dev-zzo/stebus/README.md

# IEEE 1000 / STEBus designs

This repository contains hardware designs based on the IEEE 1000 aka STE bus.

# Designs included

* S68k8: MC68008FN CPU board + bus arbiter
* STEP1: I/O prototyping board
