dev-zzo/stebus/S68k8_revB/S68k8.kicad_pcb

## KiCad design S68k8_revB/S68k8.kicad_pcb (2021-01-23)

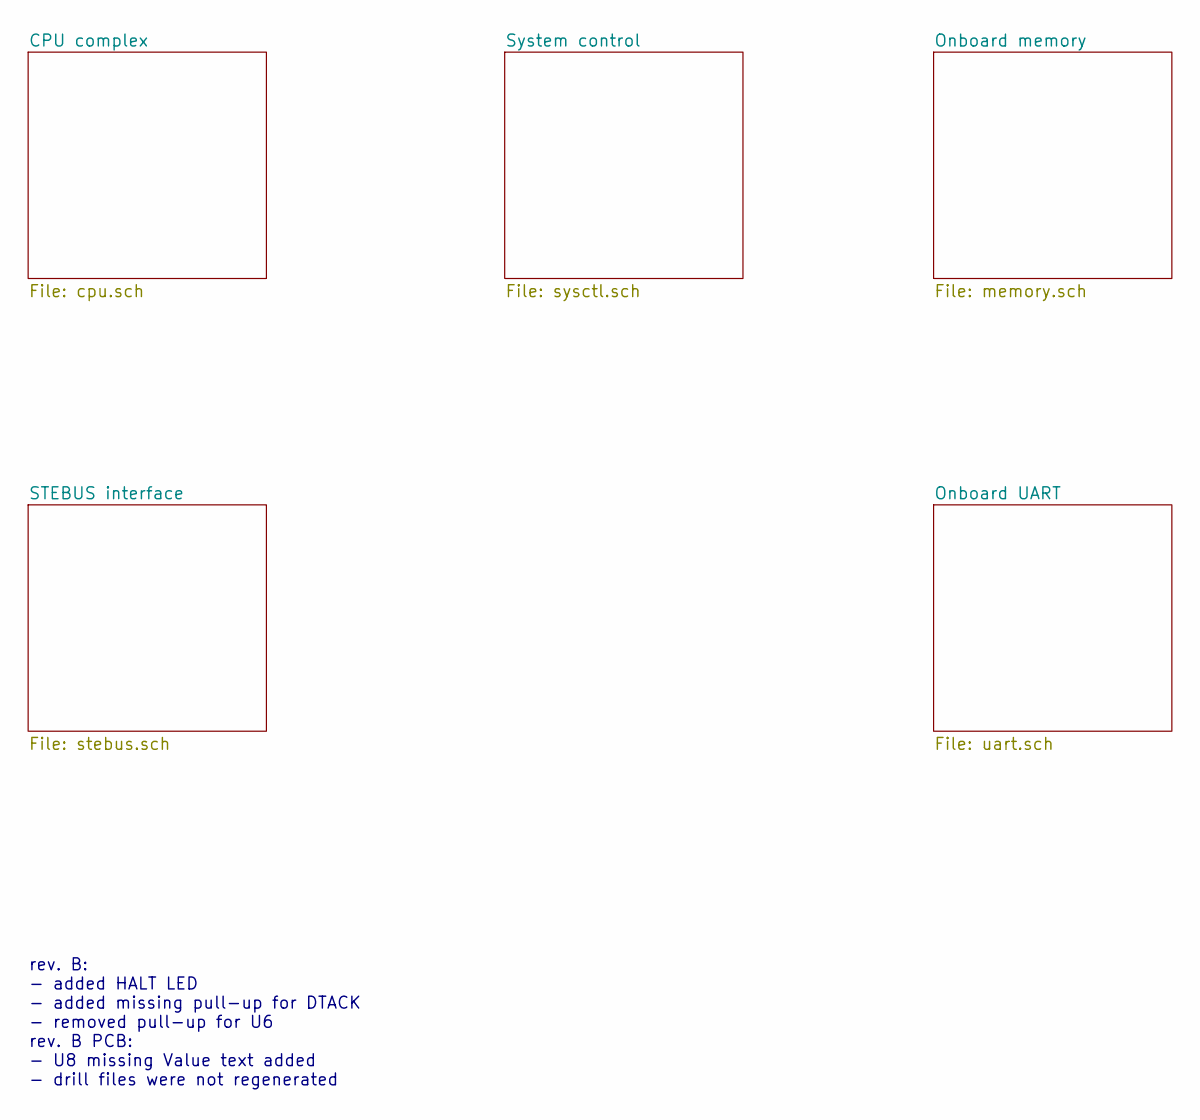
[picture p1: schematic S68k8.sch]

Notes on the sheet:
rev. B: - added HALT LED - added missing pull-up for DTACK - removed pull-up for U6 rev. B PCB: - U8 missing Value text added - drill files were not regenerated

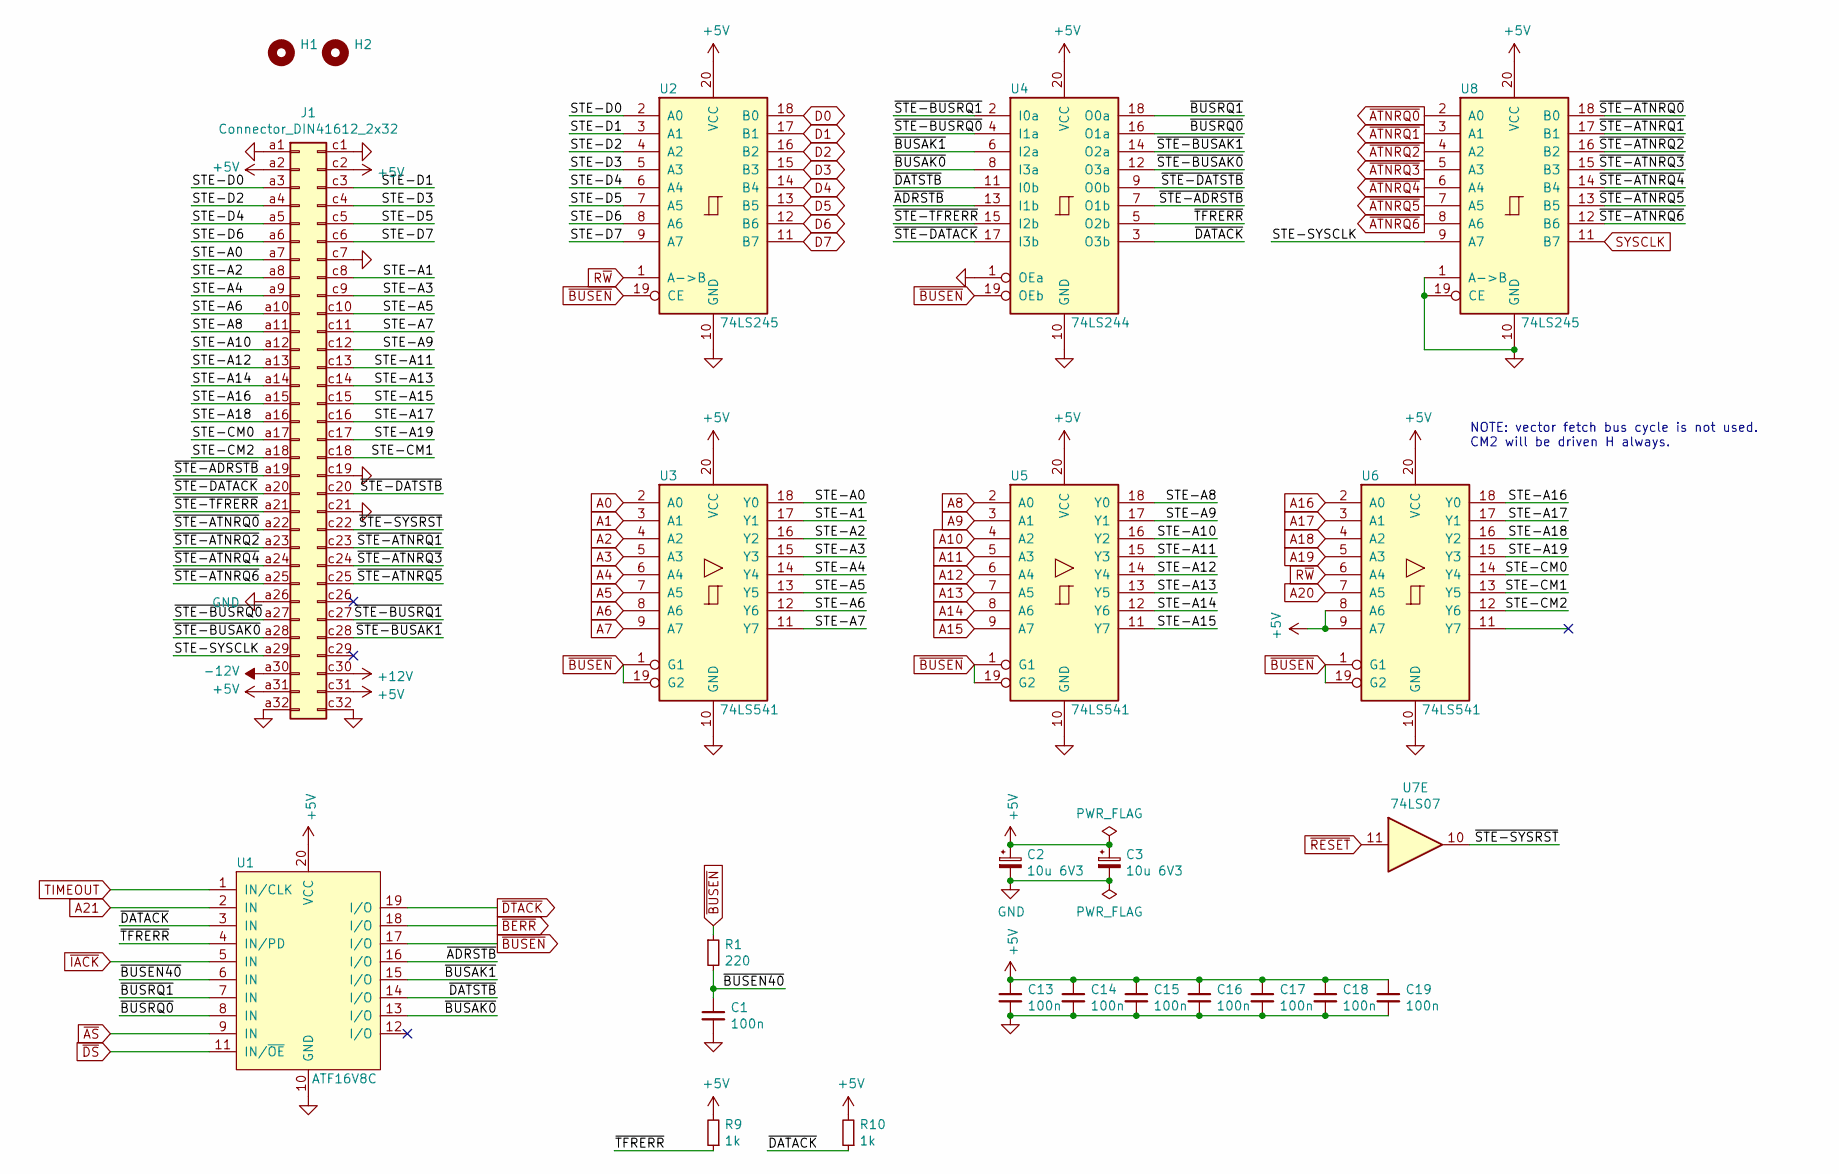
[picture p2: schematic stebus.sch]

Parts:
C1, C13, C14, C15, C16, C17, C18, C19: 100n; C_Rect_L7.0mm_W2.0mm_P5.00mm
C2, C3: 10u 6V3; CP_Radial_Tantal_D4.5mm_P5.00mm
H1, H2: MountingHole; MountingHole_2.7mm_M2.5
J1: Connector_DIN41612_2x32; DIN41612_C_2x32_Male_Horizontal_THT
R1: 220; R_Axial_DIN0204_L3.6mm_D1.6mm_P7.62mm_Horizontal
R9, R10: 1k; R_Axial_DIN0204_L3.6mm_D1.6mm_P7.62mm_Horizontal
U1: ATF16V8C; DIP-20_W7.62mm
U2, U8: 74LS245; DIP-20_W7.62mm
U3, U5, U6: 74LS541; DIP-20_W7.62mm
U4: 74LS244; DIP-20_W7.62mm
U7: 74LS07; DIP-14_W7.62mm

Connections:
+5V: C2.1, C3.1, C13.1, C14.1, C15.1, C16.1, C17.1, C18.1, C19.1, J1.a2, J1.a31, J1.c2, J1.c31, R9.2, R10.2, U1.20 (VCC), U2.20 (VCC), U3.20 (VCC), U4.20 (VCC), U5.20 (VCC), U6.8 (A6), U6.9 (A7), U6.20 (VCC), U8.20 (VCC); also elsewhere on the board
+12V: J1.c30; also elsewhere on the board
-12V: J1.a30; also elsewhere on the board
/STEBUS interface/STE-A0: J1.a7, U3.18 (Y0)
/STEBUS interface/STE-A1: J1.c8, U3.17 (Y1)
/STEBUS interface/STE-A2: J1.a8, U3.16 (Y2)
/STEBUS interface/STE-A3: J1.c9, U3.15 (Y3)
/STEBUS interface/STE-A4: J1.a9, U3.14 (Y4)
/STEBUS interface/STE-A5: J1.c10, U3.13 (Y5)
/STEBUS interface/STE-A6: J1.a10, U3.12 (Y6)
/STEBUS interface/STE-A7: J1.c11, U3.11 (Y7)
/STEBUS interface/STE-A8: J1.a11, U5.18 (Y0)
/STEBUS interface/STE-A9: J1.c12, U5.17 (Y1)
/STEBUS interface/STE-A10: J1.a12, U5.16 (Y2)
/STEBUS interface/STE-A11: J1.c13, U5.15 (Y3)
/STEBUS interface/STE-A12: J1.a13, U5.14 (Y4)
/STEBUS interface/STE-A13: J1.c14, U5.13 (Y5)
/STEBUS interface/STE-A14: J1.a14, U5.12 (Y6)
/STEBUS interface/STE-A15: J1.c15, U5.11 (Y7)
/STEBUS interface/STE-A16: J1.a15, U6.18 (Y0)
/STEBUS interface/STE-A17: J1.c16, U6.17 (Y1)
/STEBUS interface/STE-A18: J1.a16, U6.16 (Y2)
/STEBUS interface/STE-A19: J1.c17, U6.15 (Y3)
/STEBUS interface/STE-CM0: J1.a17, U6.14 (Y4)
/STEBUS interface/STE-CM1: J1.c18, U6.13 (Y5)
/STEBUS interface/STE-CM2: J1.a18, U6.12 (Y6)
/STEBUS interface/STE-D0: J1.a3, U2.2 (A0)
/STEBUS interface/STE-D1: J1.c3, U2.3 (A1)
/STEBUS interface/STE-D2: J1.a4, U2.4 (A2)
/STEBUS interface/STE-D3: J1.c4, U2.5 (A3)
/STEBUS interface/STE-D4: J1.a5, U2.6 (A4)
/STEBUS interface/STE-D5: J1.c5, U2.7 (A5)
/STEBUS interface/STE-D6: J1.a6, U2.8 (A6)
/STEBUS interface/STE-D7: J1.c6, U2.9 (A7)
/STEBUS interface/STE-SYSCLK: J1.a29, U8.9 (A7)
/STEBUS interface/~ADRSTB: U1.16 (I/O), U4.13 (I1b)
/STEBUS interface/~BUSAK0: U1.13 (I/O), U4.8 (I3a)
/STEBUS interface/~BUSAK1: U1.15 (I/O), U4.6 (I2a)
/STEBUS interface/~BUSEN40: C1.1, R1.2, U1.6 (IN)
/STEBUS interface/~BUSRQ0: U1.8 (IN), U4.16 (O1a)
/STEBUS interface/~BUSRQ1: U1.7 (IN), U4.18 (O0a)
/STEBUS interface/~DATACK: R10.1, U1.3 (IN), U4.3 (O3b)
/STEBUS interface/~DATSTB: U1.14 (I/O), U4.11 (I0b)
/STEBUS interface/~STE-ADRSTB: J1.a19, U4.7 (O1b)
/STEBUS interface/~STE-ATNRQ0: J1.a22, U8.18 (B0)
/STEBUS interface/~STE-ATNRQ1: J1.c23, U8.17 (B1)
/STEBUS interface/~STE-ATNRQ2: J1.a23, U8.16 (B2)
/STEBUS interface/~STE-ATNRQ3: J1.c24, U8.15 (B3)
/STEBUS interface/~STE-ATNRQ4: J1.a24, U8.14 (B4)
/STEBUS interface/~STE-ATNRQ5: J1.c25, U8.13 (B5)
/STEBUS interface/~STE-ATNRQ6: J1.a25, U8.12 (B6)
/STEBUS interface/~STE-BUSAK0: J1.a28, U4.12 (O3a)
/STEBUS interface/~STE-BUSAK1: J1.c28, U4.14 (O2a)
/STEBUS interface/~STE-BUSRQ0: J1.a27, U4.4 (I1a)
/STEBUS interface/~STE-BUSRQ1: J1.c27, U4.2 (I0a)
/STEBUS interface/~STE-DATACK: J1.a20, U4.17 (I3b)
/STEBUS interface/~STE-DATSTB: J1.c20, U4.9 (O0b)
/STEBUS interface/~STE-SYSRST: J1.c22, U7.10
/STEBUS interface/~STE-TFRERR: J1.a21, U4.15 (I2b)
/STEBUS interface/~TFRERR: R9.1, U1.4 (IN/PD), U4.5 (O2b)
A0: U3.2 (A0); also elsewhere on the board
A1: U3.3 (A1); also elsewhere on the board
A2: U3.4 (A2); also elsewhere on the board
A3: U3.5 (A3); also elsewhere on the board
A4: U3.6 (A4); also elsewhere on the board
A5: U3.7 (A5); also elsewhere on the board
A6: U3.8 (A6); also elsewhere on the board
A7: U3.9 (A7); also elsewhere on the board
A8: U5.2 (A0); also elsewhere on the board
A9: U5.3 (A1); also elsewhere on the board
A10: U5.4 (A2); also elsewhere on the board
A11: U5.5 (A3); also elsewhere on the board
A12: U5.6 (A4); also elsewhere on the board
A13: U5.7 (A5); also elsewhere on the board
A14: U5.8 (A6); also elsewhere on the board
A15: U5.9 (A7); also elsewhere on the board
A16: U6.2 (A0); also elsewhere on the board
A17: U6.3 (A1); also elsewhere on the board
A18: U6.4 (A2); also elsewhere on the board
A19: U6.5 (A3); also elsewhere on the board
A20: U6.7 (A5); also elsewhere on the board
A21: U1.2 (IN); also elsewhere on the board
D0: U2.18 (B0); also elsewhere on the board
D1: U2.17 (B1); also elsewhere on the board
D2: U2.16 (B2); also elsewhere on the board
D3: U2.15 (B3); also elsewhere on the board
D4: U2.14 (B4); also elsewhere on the board
D5: U2.13 (B5); also elsewhere on the board
D6: U2.12 (B6); also elsewhere on the board
D7: U2.11 (B7); also elsewhere on the board
GND: C1.2, C2.2, C3.2, C13.2, C14.2, C15.2, C16.2, C17.2, C18.2, C19.2, J1.a1, J1.a26, J1.a32, J1.c1, J1.c7, J1.c19, J1.c21, J1.c32, U1.10 (GND), U2.10 (GND), U3.10 (GND), U4.1 (OEa), U4.10 (GND), U5.10 (GND), U6.10 (GND), U8.1 (A->B), U8.10 (GND), U8.19 (CE); also elsewhere on the board
R~W: U2.1 (A->B), U6.6 (A4); also elsewhere on the board
SYSCLK: U8.11 (B7); also elsewhere on the board
TIMEOUT: U1.1 (IN/CLK); also elsewhere on the board
~AS: U1.9 (IN); also elsewhere on the board
~ATNRQ0: U8.2 (A0); also elsewhere on the board
~ATNRQ1: U8.3 (A1); also elsewhere on the board
~ATNRQ2: U8.4 (A2); also elsewhere on the board
~ATNRQ3: U8.5 (A3); also elsewhere on the board
~ATNRQ4: U8.6 (A4); also elsewhere on the board
~ATNRQ5: U8.7 (A5); also elsewhere on the board
~ATNRQ6: U8.8 (A6); also elsewhere on the board
~BERR: U1.18 (I/O); also elsewhere on the board
~BUSEN: R1.1, U1.17 (I/O), U2.19 (CE), U3.1 (G1), U3.19 (G2), U4.19 (OEb), U5.1 (G1), U5.19 (G2), U6.1 (G1), U6.19 (G2); also elsewhere on the board
~DS: U1.11 (IN/~OE); also elsewhere on the board
~DTACK: U1.19 (I/O); also elsewhere on the board
~IACK: U1.5 (IN); also elsewhere on the board
~RESET: U7.11; also elsewhere on the board

Notes on the sheet:
NOTE: vector fetch bus cycle is not used. CM2 will be driven H always.

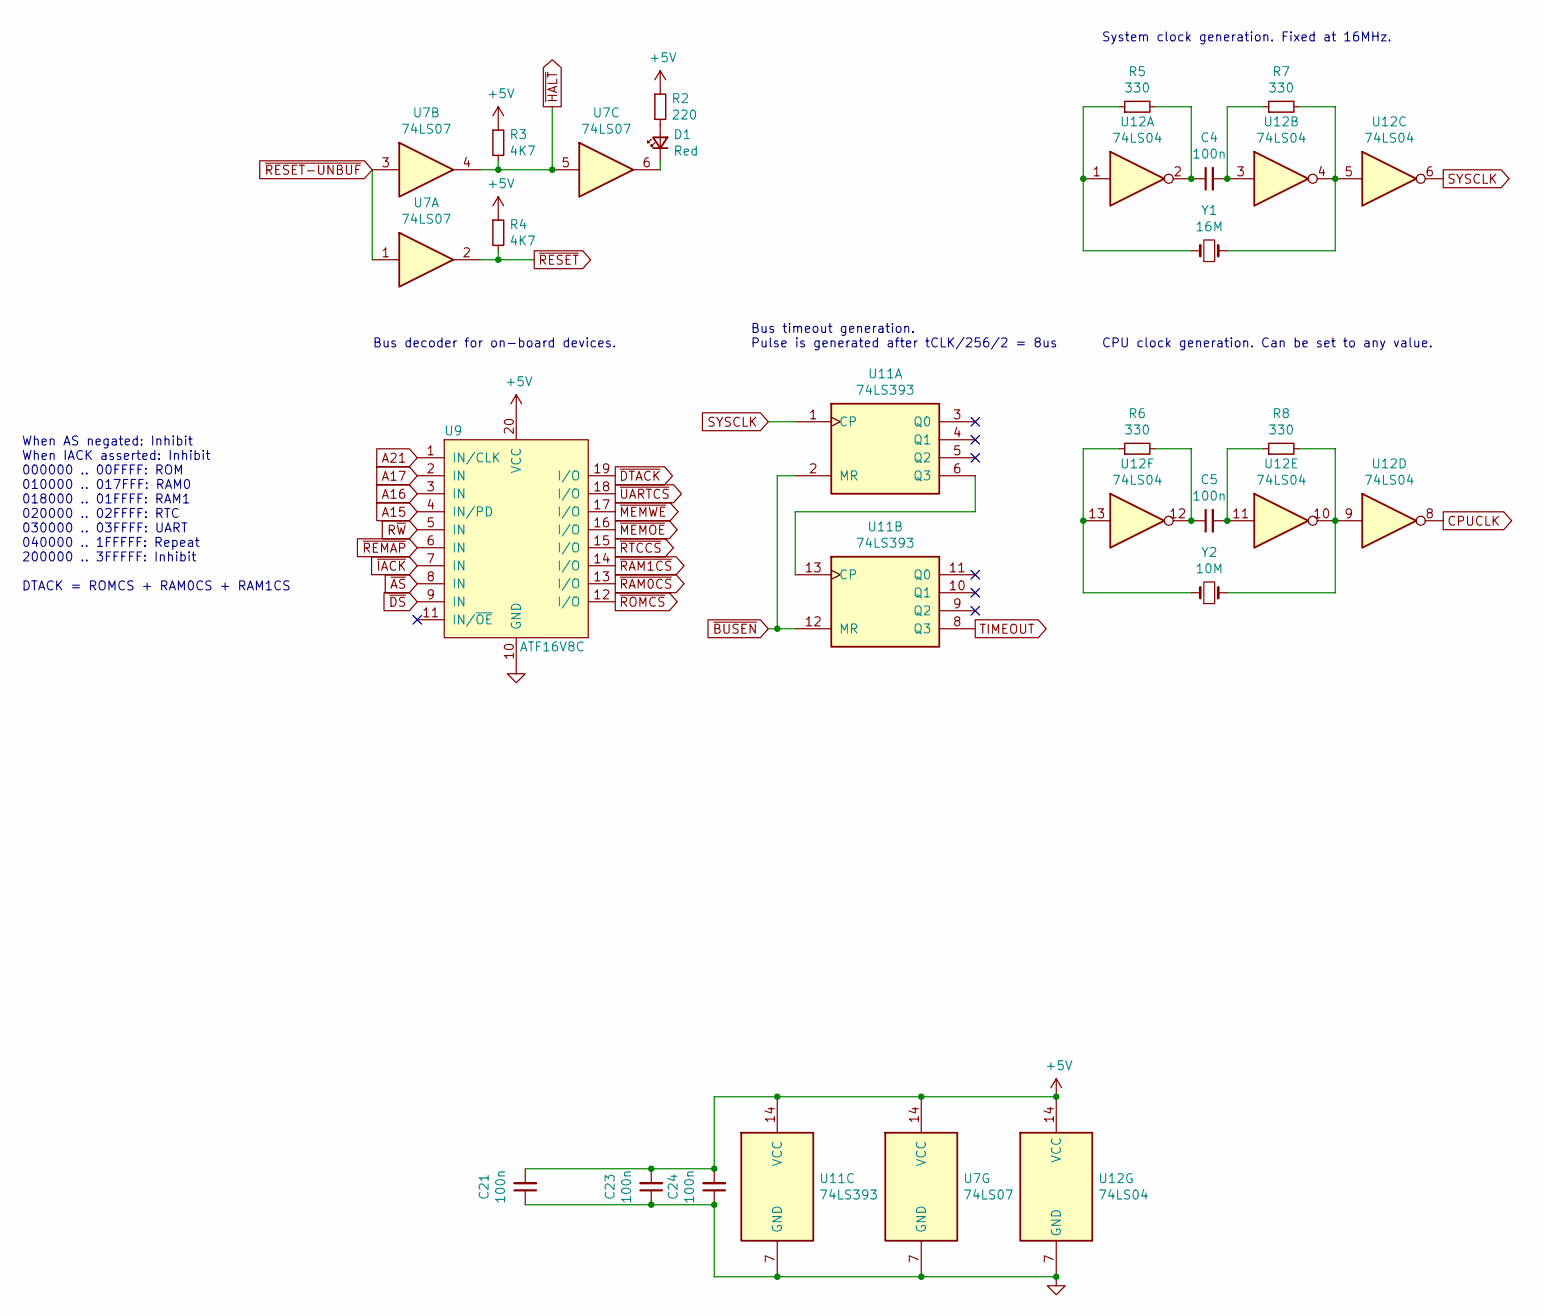
[picture p3: schematic sysctl.sch]

Parts:
C4, C5, C21, C23, C24: 100n; C_Rect_L7.0mm_W2.0mm_P5.00mm
D1: Red; LED_D5.0mm_Horizontal_O3.81mm_Z3.0mm
R2: 220; R_Axial_DIN0204_L3.6mm_D1.6mm_P7.62mm_Horizontal
R3, R4: 4K7; R_Axial_DIN0204_L3.6mm_D1.6mm_P7.62mm_Horizontal
R5, R6, R7, R8: 330; R_Axial_DIN0204_L3.6mm_D1.6mm_P7.62mm_Horizontal
U7: 74LS07; DIP-14_W7.62mm
U9: ATF16V8C; DIP-20_W7.62mm
U11: 74LS393; DIP-14_W7.62mm
U12: 74LS04; DIP-14_W7.62mm
Y1: 16M; Crystal_HC49-U_Vertical
Y2: 10M; Crystal_HC49-U_Vertical

Connections:
+5V: C21.2, C23.2, C24.2, R2.1, R3.1, R4.1, U7.14 (VCC), U9.20 (VCC), U11.14 (VCC), U12.14 (VCC); also elsewhere on the board
A15: U9.4 (IN/PD); also elsewhere on the board
A16: U9.3 (IN); also elsewhere on the board
A17: U9.2 (IN); also elsewhere on the board
A21: U9.1 (IN/CLK); also elsewhere on the board
CPUCLK: U12.8; also elsewhere on the board
GND: C21.1, C23.1, C24.1, U7.7 (GND), U9.10 (GND), U11.7 (GND), U12.7 (GND); also elsewhere on the board
unnamed: C4.1, R5.2, U12.2
unnamed: C4.2, R7.1, U12.3
unnamed: C5.1, R6.2, U12.12
unnamed: C5.2, R8.1, U12.11
unnamed: D1.1 (K), U7.6
unnamed: D1.2 (A), R2.2
unnamed: R5.1, U12.1, Y1.1
unnamed: R6.1, U12.13, Y2.1
unnamed: R7.2, U12.4, U12.5, Y1.2
unnamed: R8.2, U12.9, U12.10, Y2.2
unnamed: U11.6 (Q3), U11.13 (CP)
R~W: U9.5 (IN); also elsewhere on the board
SYSCLK: U11.1 (CP), U12.6; also elsewhere on the board
TIMEOUT: U11.8 (Q3); also elsewhere on the board
~AS: U9.8 (IN); also elsewhere on the board
~BUSEN: U11.2 (MR), U11.12 (MR); also elsewhere on the board
~DS: U9.9 (IN); also elsewhere on the board
~DTACK: U9.19 (I/O); also elsewhere on the board
~HALT: R3.2, U7.4, U7.5; also elsewhere on the board
~IACK: U9.7 (IN); also elsewhere on the board
~MEMOE: U9.16 (I/O); also elsewhere on the board
~MEMWE: U9.17 (I/O); also elsewhere on the board
~RAM0CS: U9.13 (I/O); also elsewhere on the board
~RAM1CS: U9.14 (I/O); also elsewhere on the board
~REMAP: U9.6 (IN); also elsewhere on the board
~RESET: R4.2, U7.2; also elsewhere on the board
~RESET-UNBUF: U7.1, U7.3; also elsewhere on the board
~ROMCS: U9.12 (I/O); also elsewhere on the board
~RTCCS: U9.15 (I/O); also elsewhere on the board
~UARTCS: U9.18 (I/O); also elsewhere on the board

Notes on the sheet:
When AS negated: Inhibit When IACK asserted: Inhibit 000000 .. 00FFFF: ROM 010000 .. 017FFF: RAM0 018000 .. 01FFFF: RAM1 020000 .. 02FFFF: RTC 030000 .. 03FFFF: UART 040000 .. 1FFFFF: Repeat 200000 .. 3FFFFF: Inhibit DTACK = ROMCS + RAM0CS + RAM1CS
Bus timeout generation. Pulse is generated after tCLK/256/2 = 8us
System clock generation. Fixed at 16MHz.
CPU clock generation. Can be set to any value.
Bus decoder for on-board devices.

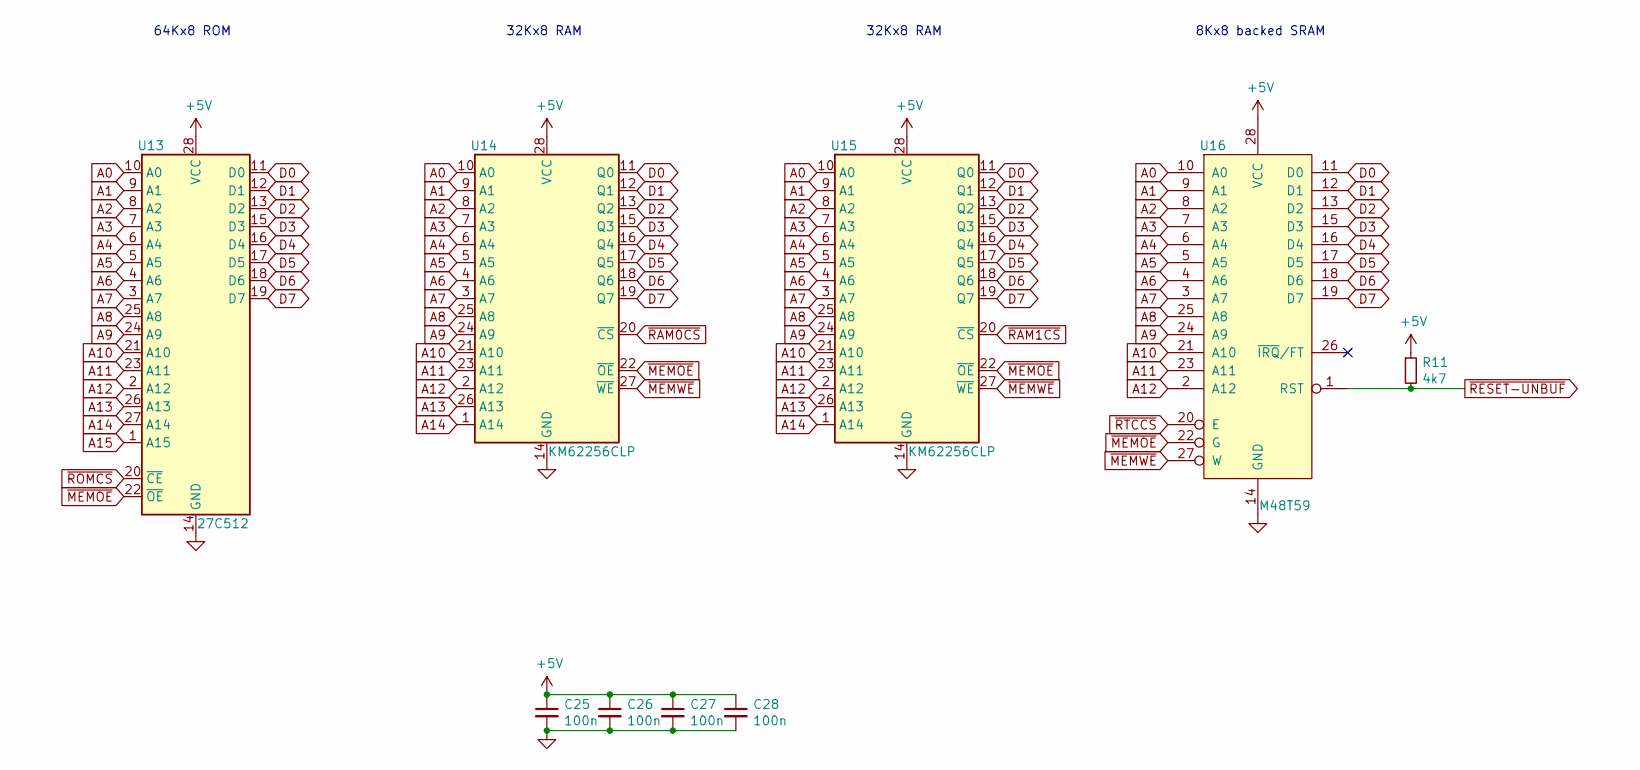
[picture p4: schematic memory.sch]

Parts:
C25, C26, C27, C28: 100n; C_Rect_L7.0mm_W2.0mm_P5.00mm
R11: 4k7; R_Axial_DIN0204_L3.6mm_D1.6mm_P7.62mm_Horizontal
U13: 27C512; DIP-28_W15.24mm_Socket
U14, U15: KM62256CLP; DIP-28_W15.24mm_Socket
U16: M48T59; DIP-28_W15.24mm_Socket

Connections:
+5V: C25.1, C26.1, C27.1, C28.1, R11.1, U13.28 (VCC), U14.28 (VCC), U15.28 (VCC), U16.28 (VCC); also elsewhere on the board
A0: U13.10 (A0), U14.10 (A0), U15.10 (A0), U16.10 (A0); also elsewhere on the board
A1: U13.9 (A1), U14.9 (A1), U15.9 (A1), U16.9 (A1); also elsewhere on the board
A2: U13.8 (A2), U14.8 (A2), U15.8 (A2), U16.8 (A2); also elsewhere on the board
A3: U13.7 (A3), U14.7 (A3), U15.7 (A3), U16.7 (A3); also elsewhere on the board
A4: U13.6 (A4), U14.6 (A4), U15.6 (A4), U16.6 (A4); also elsewhere on the board
A5: U13.5 (A5), U14.5 (A5), U15.5 (A5), U16.5 (A5); also elsewhere on the board
A6: U13.4 (A6), U14.4 (A6), U15.4 (A6), U16.4 (A6); also elsewhere on the board
A7: U13.3 (A7), U14.3 (A7), U15.3 (A7), U16.3 (A7); also elsewhere on the board
A8: U13.25 (A8), U14.25 (A8), U15.25 (A8), U16.25 (A8); also elsewhere on the board
A9: U13.24 (A9), U14.24 (A9), U15.24 (A9), U16.24 (A9); also elsewhere on the board
A10: U13.21 (A10), U14.21 (A10), U15.21 (A10), U16.21 (A10); also elsewhere on the board
A11: U13.23 (A11), U14.23 (A11), U15.23 (A11), U16.23 (A11); also elsewhere on the board
A12: U13.2 (A12), U14.2 (A12), U15.2 (A12), U16.2 (A12); also elsewhere on the board
A13: U13.26 (A13), U14.26 (A13), U15.26 (A13); also elsewhere on the board
A14: U13.27 (A14), U14.1 (A14), U15.1 (A14); also elsewhere on the board
A15: U13.1 (A15); also elsewhere on the board
D0: U13.11 (D0), U14.11 (Q0), U15.11 (Q0), U16.11 (D0); also elsewhere on the board
D1: U13.12 (D1), U14.12 (Q1), U15.12 (Q1), U16.12 (D1); also elsewhere on the board
D2: U13.13 (D2), U14.13 (Q2), U15.13 (Q2), U16.13 (D2); also elsewhere on the board
D3: U13.15 (D3), U14.15 (Q3), U15.15 (Q3), U16.15 (D3); also elsewhere on the board
D4: U13.16 (D4), U14.16 (Q4), U15.16 (Q4), U16.16 (D4); also elsewhere on the board
D5: U13.17 (D5), U14.17 (Q5), U15.17 (Q5), U16.17 (D5); also elsewhere on the board
D6: U13.18 (D6), U14.18 (Q6), U15.18 (Q6), U16.18 (D6); also elsewhere on the board
D7: U13.19 (D7), U14.19 (Q7), U15.19 (Q7), U16.19 (D7); also elsewhere on the board
GND: C25.2, C26.2, C27.2, C28.2, U13.14 (GND), U14.14 (GND), U15.14 (GND), U16.14 (GND); also elsewhere on the board
~MEMOE: U13.22 (~OE), U14.22 (~OE), U15.22 (~OE), U16.22 (G); also elsewhere on the board
~MEMWE: U14.27 (~WE), U15.27 (~WE), U16.27 (W); also elsewhere on the board
~RAM0CS: U14.20 (~CS); also elsewhere on the board
~RAM1CS: U15.20 (~CS); also elsewhere on the board
~RESET-UNBUF: R11.2, U16.1 (RST); also elsewhere on the board
~ROMCS: U13.20 (~CE); also elsewhere on the board
~RTCCS: U16.20 (E); also elsewhere on the board

Notes on the sheet:
64Kx8 ROM
32Kx8 RAM
8Kx8 backed SRAM

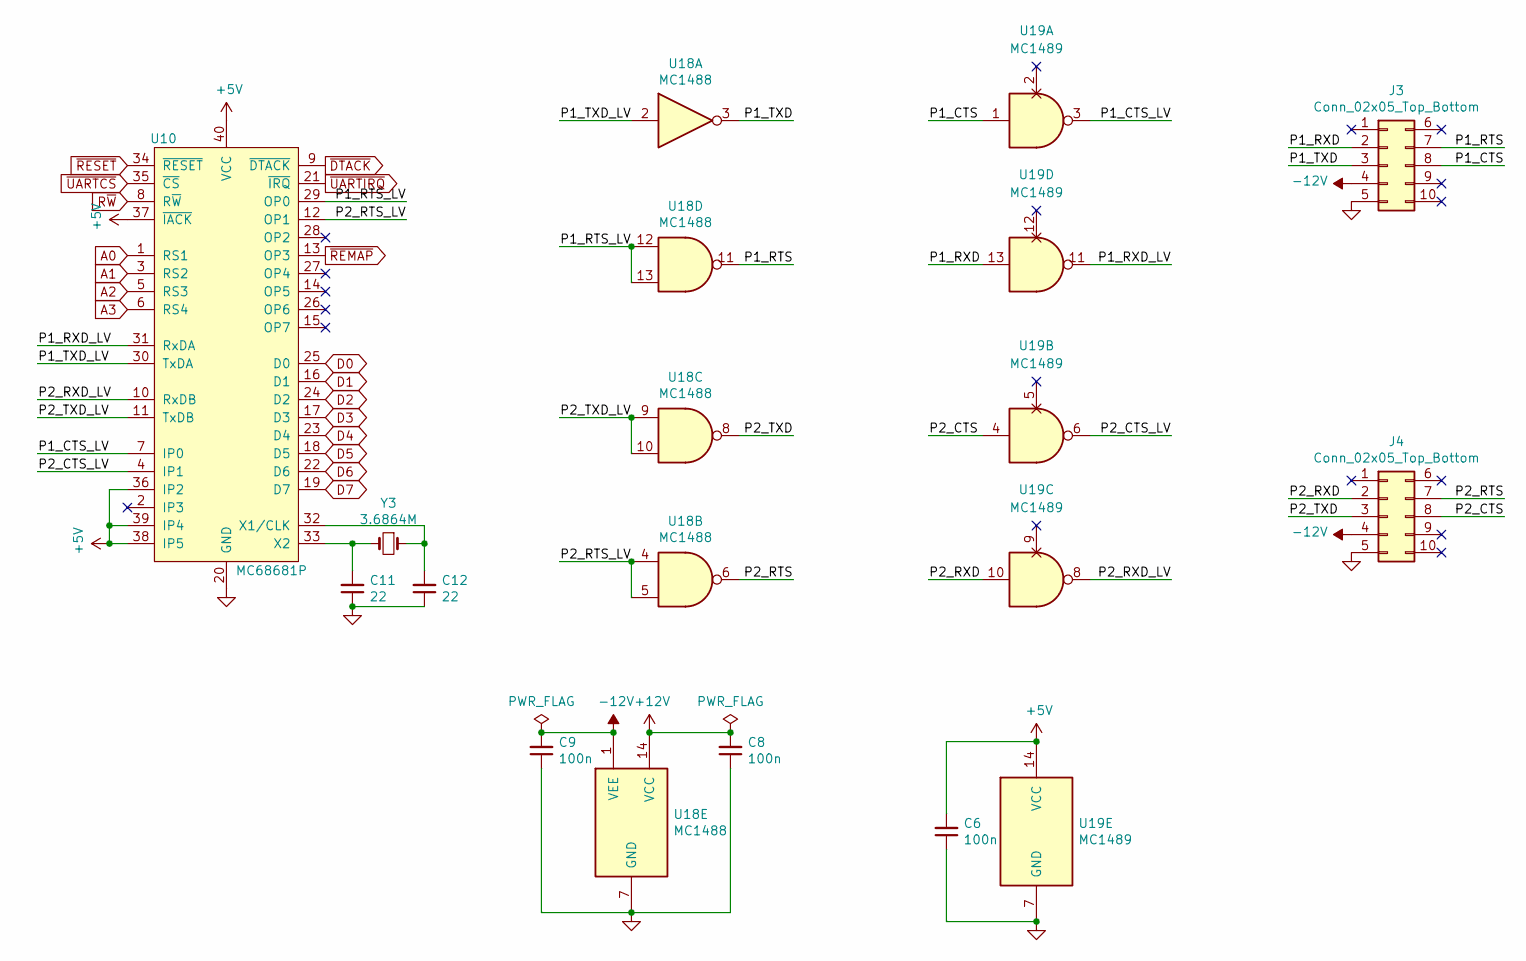
[picture p5: schematic uart.sch]

Parts:
C6, C8, C9: 100n; C_Rect_L7.0mm_W2.0mm_P5.00mm
C11, C12: 22; C_Rect_L7.0mm_W2.0mm_P5.00mm
J3, J4: Conn_02x05_Top_Bottom; PinSocket_2x05_P2.54mm_Vertical
U10: MC68681P; DIP-40_W15.24mm
U18: MC1488; DIP-14_W7.62mm
U19: MC1489; DIP-14_W7.62mm
Y3: 3.6864M; Crystal_HC49-U_Vertical

Connections:
+5V: C6.2, U10.36 (IP2), U10.37 (~IACK), U10.38 (IP5), U10.39 (IP4), U10.40 (VCC), U19.14 (VCC); also elsewhere on the board
+12V: C8.2, U18.14 (VCC); also elsewhere on the board
-12V: C9.2, J3.4, J4.4, U18.1 (VEE); also elsewhere on the board
/Onboard UART/P1_CTS: J3.8, U19.1
/Onboard UART/P1_CTS_LV: U10.7 (IP0), U19.3
/Onboard UART/P1_RTS: J3.7, U18.11
/Onboard UART/P1_RTS_LV: U10.29 (OP0), U18.12, U18.13
/Onboard UART/P1_RXD: J3.2, U19.13
/Onboard UART/P1_RXD_LV: U10.31 (RxDA), U19.11
/Onboard UART/P1_TXD: J3.3, U18.3
/Onboard UART/P1_TXD_LV: U10.30 (TxDA), U18.2
/Onboard UART/P2_CTS: J4.8, U19.4
/Onboard UART/P2_CTS_LV: U10.4 (IP1), U19.6
/Onboard UART/P2_RTS: J4.7, U18.6
/Onboard UART/P2_RTS_LV: U10.12 (OP1), U18.4, U18.5
/Onboard UART/P2_RXD: J4.2, U19.10
/Onboard UART/P2_RXD_LV: U10.10 (RxDB), U19.8
/Onboard UART/P2_TXD: J4.3, U18.8
/Onboard UART/P2_TXD_LV: U10.11 (TxDB), U18.9, U18.10
A0: U10.1 (RS1); also elsewhere on the board
A1: U10.3 (RS2); also elsewhere on the board
A2: U10.5 (RS3); also elsewhere on the board
A3: U10.6 (RS4); also elsewhere on the board
D0: U10.25 (D0); also elsewhere on the board
D1: U10.16 (D1); also elsewhere on the board
D2: U10.24 (D2); also elsewhere on the board
D3: U10.17 (D3); also elsewhere on the board
D4: U10.23 (D4); also elsewhere on the board
D5: U10.18 (D5); also elsewhere on the board
D6: U10.22 (D6); also elsewhere on the board
D7: U10.19 (D7); also elsewhere on the board
GND: C6.1, C8.1, C9.1, C11.1, C12.1, J3.5, J4.5, U10.20 (GND), U18.7 (GND), U19.7 (GND); also elsewhere on the board
unnamed: C11.2, U10.33 (X2), Y3.2
unnamed: C12.2, U10.32 (X1/CLK), Y3.1
R~W: U10.8 (R~W); also elsewhere on the board
~DTACK: U10.9 (~DTACK); also elsewhere on the board
~REMAP: U10.13 (OP3); also elsewhere on the board
~RESET: U10.34 (~RESET); also elsewhere on the board
~UARTCS: U10.35 (~CS); also elsewhere on the board
~UARTIRQ: U10.21 (~IRQ); also elsewhere on the board

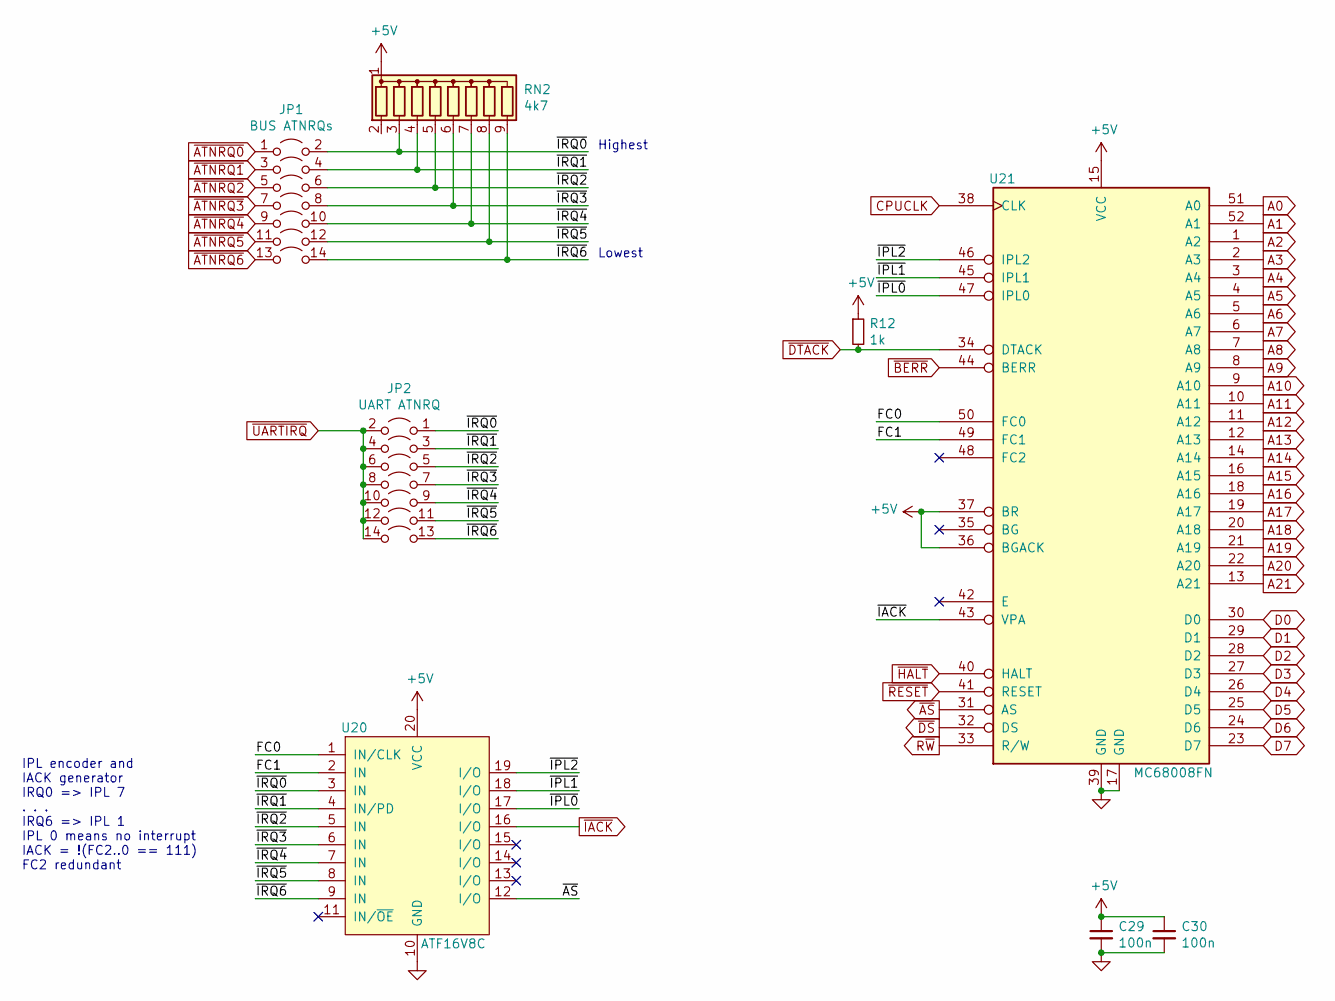
[picture p6: schematic cpu.sch]

Parts:
C29, C30: 100n; C_Rect_L7.0mm_W2.0mm_P5.00mm
JP1: BUS ATNRQs; PinSocket_2x07_P2.54mm_Vertical
JP2: UART ATNRQ; PinSocket_2x07_P2.54mm_Vertical
R12: 1k; R_Axial_DIN0204_L3.6mm_D1.6mm_P7.62mm_Horizontal
RN2: 4k7; R_Array_SIP9
U20: ATF16V8C; DIP-20_W7.62mm
U21: MC68008FN; PLCC-52_THT-Socket

Connections:
+5V: C29.1, C30.1, R12.1, RN2.1 (common), U20.20 (VCC), U21.15 (VCC), U21.36 (BGACK), U21.37 (BR); also elsewhere on the board
/CPU complex/FC0: U20.1 (IN/CLK), U21.50 (FC0)
/CPU complex/FC1: U20.2 (IN), U21.49 (FC1)
/CPU complex/~IPL0: U20.17 (I/O), U21.47 (IPL0)
/CPU complex/~IPL1: U20.18 (I/O), U21.45 (IPL1)
/CPU complex/~IPL2: U20.19 (I/O), U21.46 (IPL2)
/CPU complex/~IRQ0: JP1.2 (B), JP2.1 (A), RN2.3 (R2), U20.3 (IN)
/CPU complex/~IRQ1: JP1.4 (B), JP2.3 (A), RN2.4 (R3), U20.4 (IN/PD)
/CPU complex/~IRQ2: JP1.6 (B), JP2.5 (A), RN2.5 (R4), U20.5 (IN)
/CPU complex/~IRQ3: JP1.8 (B), JP2.7 (A), RN2.6 (R5), U20.6 (IN)
/CPU complex/~IRQ4: JP1.10 (B), JP2.9 (A), RN2.7 (R6), U20.7 (IN)
/CPU complex/~IRQ5: JP1.12 (B), JP2.11 (A), RN2.8 (R7), U20.8 (IN)
/CPU complex/~IRQ6: JP1.14 (B), JP2.13 (A), RN2.9 (R8), U20.9 (IN)
A0: U21.51 (A0); also elsewhere on the board
A1: U21.52 (A1); also elsewhere on the board
A2: U21.1 (A2); also elsewhere on the board
A3: U21.2 (A3); also elsewhere on the board
A4: U21.3 (A4); also elsewhere on the board
A5: U21.4 (A5); also elsewhere on the board
A6: U21.5 (A6); also elsewhere on the board
A7: U21.6 (A7); also elsewhere on the board
A8: U21.7 (A8); also elsewhere on the board
A9: U21.8 (A9); also elsewhere on the board
A10: U21.9 (A10); also elsewhere on the board
A11: U21.10 (A11); also elsewhere on the board
A12: U21.11 (A12); also elsewhere on the board
A13: U21.12 (A13); also elsewhere on the board
A14: U21.14 (A14); also elsewhere on the board
A15: U21.16 (A15); also elsewhere on the board
A16: U21.18 (A16); also elsewhere on the board
A17: U21.19 (A17); also elsewhere on the board
A18: U21.20 (A18); also elsewhere on the board
A19: U21.21 (A19); also elsewhere on the board
A20: U21.22 (A20); also elsewhere on the board
A21: U21.13 (A21); also elsewhere on the board
CPUCLK: U21.38 (CLK); also elsewhere on the board
D0: U21.30 (D0); also elsewhere on the board
D1: U21.29 (D1); also elsewhere on the board
D2: U21.28 (D2); also elsewhere on the board
D3: U21.27 (D3); also elsewhere on the board
D4: U21.26 (D4); also elsewhere on the board
D5: U21.25 (D5); also elsewhere on the board
D6: U21.24 (D6); also elsewhere on the board
D7: U21.23 (D7); also elsewhere on the board
GND: C29.2, C30.2, U20.10 (GND), U21.17 (GND), U21.39 (GND); also elsewhere on the board
R~W: U21.33 (R/W); also elsewhere on the board
~AS: U20.12 (I/O), U21.31 (AS); also elsewhere on the board
~ATNRQ0: JP1.1 (A); also elsewhere on the board
~ATNRQ1: JP1.3 (A); also elsewhere on the board
~ATNRQ2: JP1.5 (A); also elsewhere on the board
~ATNRQ3: JP1.7 (A); also elsewhere on the board
~ATNRQ4: JP1.9 (A); also elsewhere on the board
~ATNRQ5: JP1.11 (A); also elsewhere on the board
~ATNRQ6: JP1.13 (A); also elsewhere on the board
~BERR: U21.44 (BERR); also elsewhere on the board
~DS: U21.32 (DS); also elsewhere on the board
~DTACK: R12.2, U21.34 (DTACK); also elsewhere on the board
~HALT: U21.40 (HALT); also elsewhere on the board
~IACK: U20.16 (I/O), U21.43 (VPA); also elsewhere on the board
~RESET: U21.41 (RESET); also elsewhere on the board
~UARTIRQ: JP2.2 (B), JP2.4 (B), JP2.6 (B), JP2.8 (B), JP2.10 (B), JP2.12 (B), JP2.14 (B); also elsewhere on the board

Notes on the sheet:
IPL encoder and IACK generator IRQ0 => IPL 7 . . . IRQ6 => IPL 1 IPL 0 means no interrupt IACK = !(FC2..0 == 111) FC2 redundant
Highest
Lowest

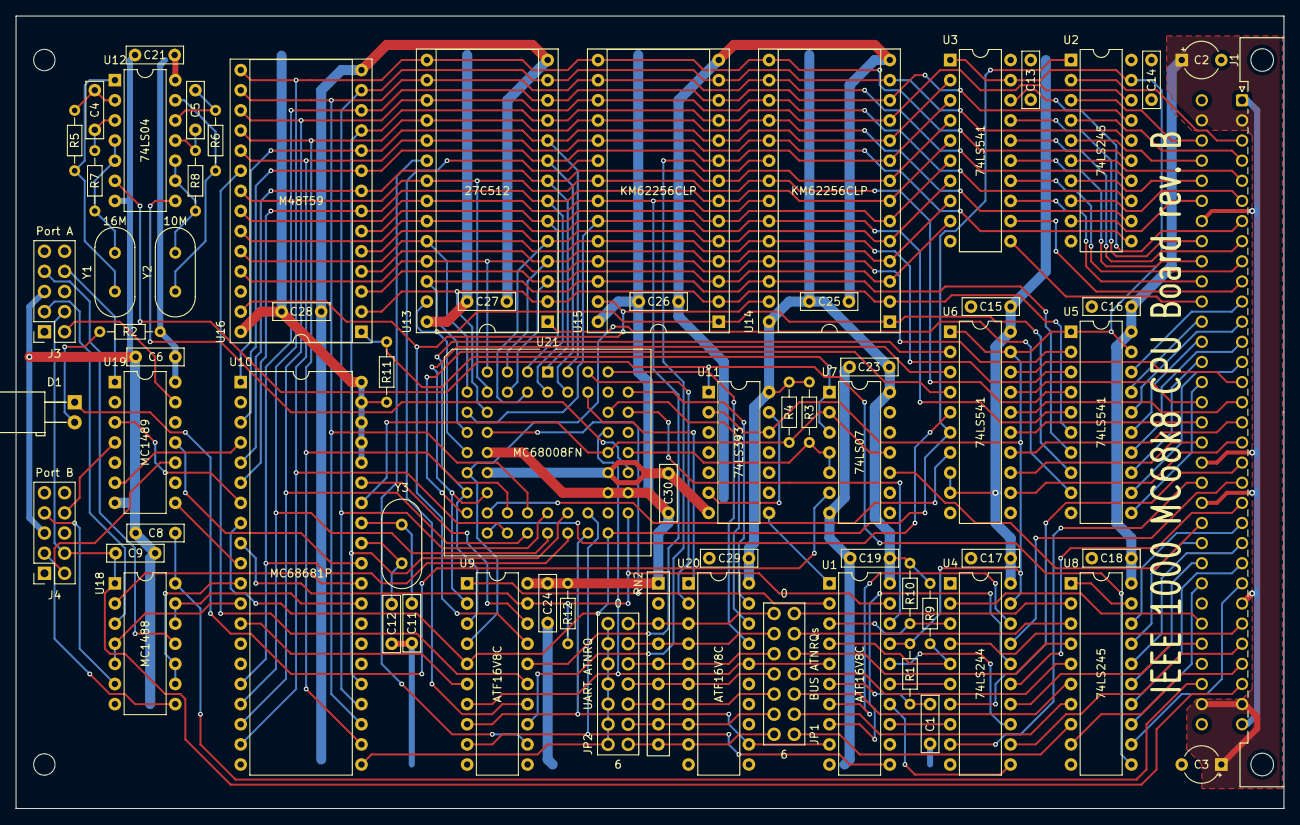
[picture p7: board S68k8.kicad_pcb from above]

Board: 2 copper layers, 160.0 x 100.0 mm, 70 parts (0 on the bottom side), 161 nets.
