dev-zzo/stebus/STEP1_revB/STEP1.kicad_pcb

## KiCad design STEP1_revB/STEP1.kicad_pcb (2021-01-19)

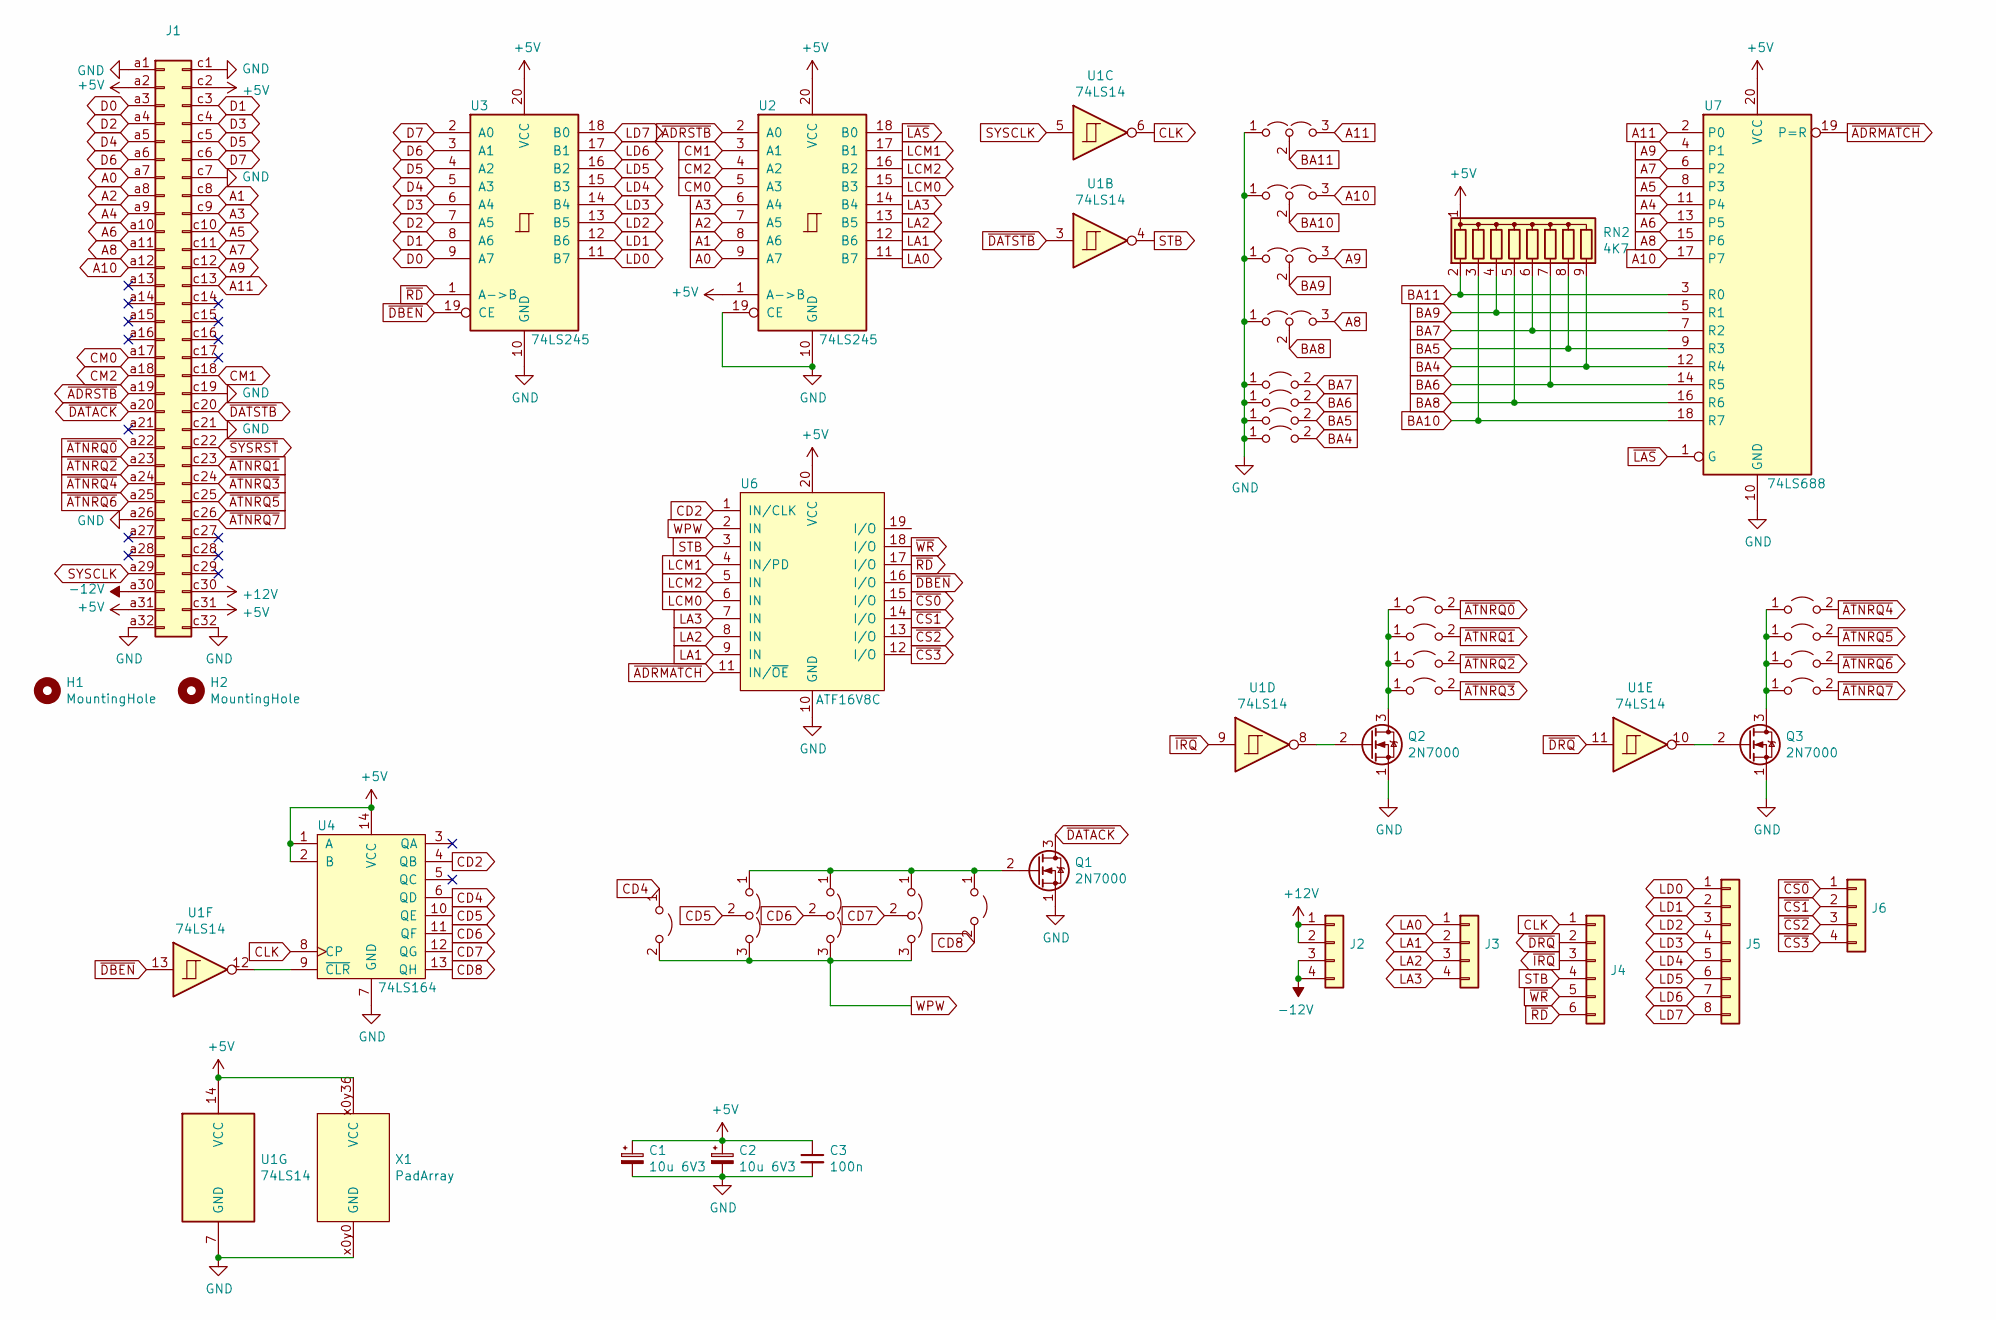
[picture p8: schematic STEP1.sch]

Parts:
C1, C2: 10u 6V3; CP_Radial_D5.0mm_P2.50mm
C3: 100n; C_Disc_D4.7mm_W2.5mm_P5.00mm
H1, H2: MountingHole; MountingHole_2.7mm_M2.5
J1: Connector_DIN41612_2x32; DIN41612_C_2x32_Male_Horizontal_THT
J2, J3, J6: Conn_01x04; PinHeader_1x04_P2.54mm_Vertical_No1
J4: Conn_01x06; PinHeader_1x06_P2.54mm_Vertical
J5: Conn_01x08; PinHeader_1x08_P2.54mm_Vertical_No1
JP1: 0; PinHeader_1x02_P2.54mm_Vertical_No1
JP2: 1; PinHeader_1x02_P2.54mm_Vertical_No1
JP3: 2; PinHeader_1x02_P2.54mm_Vertical_No1
JP4: 3; PinHeader_1x02_P2.54mm_Vertical_No1
JP5: 4; PinHeader_1x02_P2.54mm_Vertical_No1
JP6: 5; PinHeader_1x02_P2.54mm_Vertical_No1
JP7: 6; PinHeader_1x02_P2.54mm_Vertical_No1
JP8: 7; PinHeader_1x02_P2.54mm_Vertical_No1
JP9, JP14: E; PinHeader_1x02_P2.54mm_Vertical_No1
JP10, JP21: D; PinHeader_1x03_P2.54mm_Vertical_No1
JP11, JP20: C; PinHeader_1x03_P2.54mm_Vertical_No1
JP12, JP19: B; PinHeader_1x03_P2.54mm_Vertical_No1
JP13: A; PinHeader_1x02_P2.54mm_Vertical_No1
JP15: F; PinHeader_1x02_P2.54mm_Vertical_No1
JP16: G; PinHeader_1x02_P2.54mm_Vertical_No1
JP17: H; PinHeader_1x02_P2.54mm_Vertical_No1
JP18: A; PinHeader_1x03_P2.54mm_Vertical_No1
Q1, Q2, Q3: 2N7000; TO-92_Inline_Wide
RN2: 4K7; R_Array_SIP9
U1: 74LS14; DIP-14_W7.62mm
U2, U3: 74LS245; DIP-20_W7.62mm
U4: 74LS164; DIP-14_W7.62mm
U6: ATF16V8C; DIP-20_W7.62mm
U7: 74LS688; DIP-20_W7.62mm
X1: PadArray; Pad_Array

Connections:
+5V: C1.1, C2.1, C3.1, J1.a2, J1.a31, J1.c2, J1.c31, RN2.1 (common), U1.14 (VCC), U2.1 (A->B), U2.20 (VCC), U3.20 (VCC), U4.1 (A), U4.2 (B), U4.14 (VCC), U6.20 (VCC), U7.20 (VCC), X1.x0y36 (VCC), X1.x1y36 (VCC), X1.x2y36 (VCC), X1.x3y36 (VCC), X1.x4y36 (VCC), X1.x5y36 (VCC), X1.x6y36 (VCC), X1.x7y36 (VCC), X1.x8y36 (VCC), X1.x9y36 (VCC), X1.x10y36 (VCC), X1.x11y36 (VCC), X1.x12y36 (VCC), X1.x13y36 (VCC), X1.x14y36 (VCC), X1.x15y36 (VCC), X1.x16y36 (VCC), X1.x17y36 (VCC), X1.x18y36 (VCC), X1.x19y36 (VCC), X1.x20y36 (VCC), X1.x21y36 (VCC), X1.x22y36 (VCC), X1.x23y36 (VCC), X1.x24y36 (VCC), X1.x25y36 (VCC), X1.x26y36 (VCC), X1.x27y36 (VCC), X1.x28y36 (VCC), X1.x29y36 (VCC), X1.x30y36 (VCC), X1.x31y36 (VCC), X1.x32y36 (VCC), X1.x33y36 (VCC), X1.x34y36 (VCC), X1.x35y36 (VCC), X1.x36y36 (VCC), X1.x37y36 (VCC), X1.x38y36 (VCC), X1.x39y36 (VCC)
+12V: J1.c30, J2.1, J2.2
-12V: J1.a30, J2.3, J2.4
A0: J1.a7, U2.9 (A7)
A1: J1.c8, U2.8 (A6)
A2: J1.a8, U2.7 (A5)
A3: J1.c9, U2.6 (A4)
A4: J1.a9, U7.11 (P4)
A5: J1.c10, U7.8 (P3)
A6: J1.a10, U7.13 (P5)
A7: J1.c11, U7.6 (P2)
A8: J1.a11, JP21.3 (B), U7.15 (P6)
A9: J1.c12, JP20.3 (B), U7.4 (P1)
A10: J1.a12, JP19.3 (B), U7.17 (P7)
A11: J1.c13, JP18.3 (B), U7.2 (P0)
BA4: JP17.2 (B), RN2.9 (R8), U7.12 (R4)
BA5: JP16.2 (B), RN2.8 (R7), U7.9 (R3)
BA6: JP15.2 (B), RN2.7 (R6), U7.14 (R5)
BA7: JP14.2 (B), RN2.6 (R5), U7.7 (R2)
BA8: JP21.2 (C), RN2.5 (R4), U7.16 (R6)
BA9: JP20.2 (C), RN2.4 (R3), U7.5 (R1)
BA10: JP19.2 (C), RN2.3 (R2), U7.18 (R7)
BA11: JP18.2 (C), RN2.2 (R1), U7.3 (R0)
CD2: U4.4 (QB), U6.1 (IN/CLK)
CD4: JP9.1 (A), U4.6 (QD)
CD5: JP10.2 (C), U4.10 (QE)
CD6: JP11.2 (C), U4.11 (QF)
CD7: JP12.2 (C), U4.12 (QG)
CD8: JP13.2 (B), U4.13 (QH)
CLK: J4.1, U1.6, U4.8 (CP)
CM0: J1.a17, U2.5 (A3)
CM1: J1.c18, U2.3 (A1)
CM2: J1.a18, U2.4 (A2)
D0: J1.a3, U3.9 (A7)
D1: J1.c3, U3.8 (A6)
D2: J1.a4, U3.7 (A5)
D3: J1.c4, U3.6 (A4)
D4: J1.a5, U3.5 (A3)
D5: J1.c5, U3.4 (A2)
D6: J1.a6, U3.3 (A1)
D7: J1.c6, U3.2 (A0)
GND: C1.2, C2.2, C3.2, J1.a1, J1.a26, J1.a32, J1.c1, J1.c7, J1.c19, J1.c21, J1.c32, JP14.1 (A), JP15.1 (A), JP16.1 (A), JP17.1 (A), JP18.1 (A), JP19.1 (A), JP20.1 (A), JP21.1 (A), Q1.1 (S), Q2.1 (S), Q3.1 (S), U1.7 (GND), U2.10 (GND), U2.19 (CE), U3.10 (GND), U4.7 (GND), U6.10 (GND), U7.10 (GND), X1.x0y0 (GND), X1.x1y0 (GND), X1.x2y0 (GND), X1.x3y0 (GND), X1.x4y0 (GND), X1.x5y0 (GND), X1.x6y0 (GND), X1.x7y0 (GND), X1.x8y0 (GND), X1.x9y0 (GND), X1.x10y0 (GND), X1.x11y0 (GND), X1.x12y0 (GND), X1.x13y0 (GND), X1.x14y0 (GND), X1.x15y0 (GND), X1.x16y0 (GND), X1.x17y0 (GND), X1.x18y0 (GND), X1.x19y0 (GND), X1.x20y0 (GND), X1.x21y0 (GND), X1.x22y0 (GND), X1.x23y0 (GND), X1.x24y0 (GND), X1.x25y0 (GND), X1.x26y0 (GND), X1.x27y0 (GND), X1.x28y0 (GND), X1.x29y0 (GND), X1.x30y0 (GND), X1.x31y0 (GND), X1.x32y0 (GND), X1.x33y0 (GND), X1.x34y0 (GND), X1.x35y0 (GND), X1.x36y0 (GND), X1.x37y0 (GND), X1.x38y0 (GND), X1.x39y0 (GND)
LA0: J3.1, U2.11 (B7)
LA1: J3.2, U2.12 (B6), U6.9 (IN)
LA2: J3.3, U2.13 (B5), U6.8 (IN)
LA3: J3.4, U2.14 (B4), U6.7 (IN)
LCM0: U2.15 (B3), U6.6 (IN)
LCM1: U2.17 (B1), U6.4 (IN/PD)
LCM2: U2.16 (B2), U6.5 (IN)
LD0: J5.1, U3.11 (B7)
LD1: J5.2, U3.12 (B6)
LD2: J5.3, U3.13 (B5)
LD3: J5.4, U3.14 (B4)
LD4: J5.5, U3.15 (B3)
LD5: J5.6, U3.16 (B2)
LD6: J5.7, U3.17 (B1)
LD7: J5.8, U3.18 (B0)
unnamed: JP1.1 (A), JP2.1 (A), JP3.1 (A), JP4.1 (A), Q2.3 (D)
unnamed: JP5.1 (A), JP6.1 (A), JP7.1 (A), JP8.1 (A), Q3.3 (D)
unnamed: JP10.1 (A), JP11.1 (A), JP12.1 (A), JP13.1 (A), Q1.2 (G)
unnamed: Q2.2 (G), U1.8
unnamed: Q3.2 (G), U1.10
unnamed: U1.12, U4.9 (~CLR)
STB: J4.4, U1.4, U6.3 (IN)
SYSCLK: J1.a29, U1.5
WPW: JP9.2 (B), JP10.3 (B), JP11.3 (B), JP12.3 (B), U6.2 (IN)
~ADRMATCH: U6.11 (IN/~OE), U7.19 (P=R)
~ADRSTB: J1.a19, U2.2 (A0)
~ATNRQ0: J1.a22, JP1.2 (B)
~ATNRQ1: J1.c23, JP2.2 (B)
~ATNRQ2: J1.a23, JP3.2 (B)
~ATNRQ3: J1.c24, JP4.2 (B)
~ATNRQ4: J1.a24, JP5.2 (B)
~ATNRQ5: J1.c25, JP6.2 (B)
~ATNRQ6: J1.a25, JP7.2 (B)
~ATNRQ7: J1.c26, JP8.2 (B)
~CS0: J6.1, U6.15 (I/O)
~CS1: J6.2, U6.14 (I/O)
~CS2: J6.3, U6.13 (I/O)
~CS3: J6.4, U6.12 (I/O)
~DATACK: J1.a20, Q1.3 (D)
~DATSTB: J1.c20, U1.3
~DBEN: U1.13, U3.19 (CE), U6.16 (I/O)
~DRQ: J4.2, U1.11
~IRQ: J4.3, U1.9
~LAS: U2.18 (B0), U7.1 (G)
~RD: J4.6, U3.1 (A->B), U6.17 (I/O)
~WR: J4.5, U6.18 (I/O)

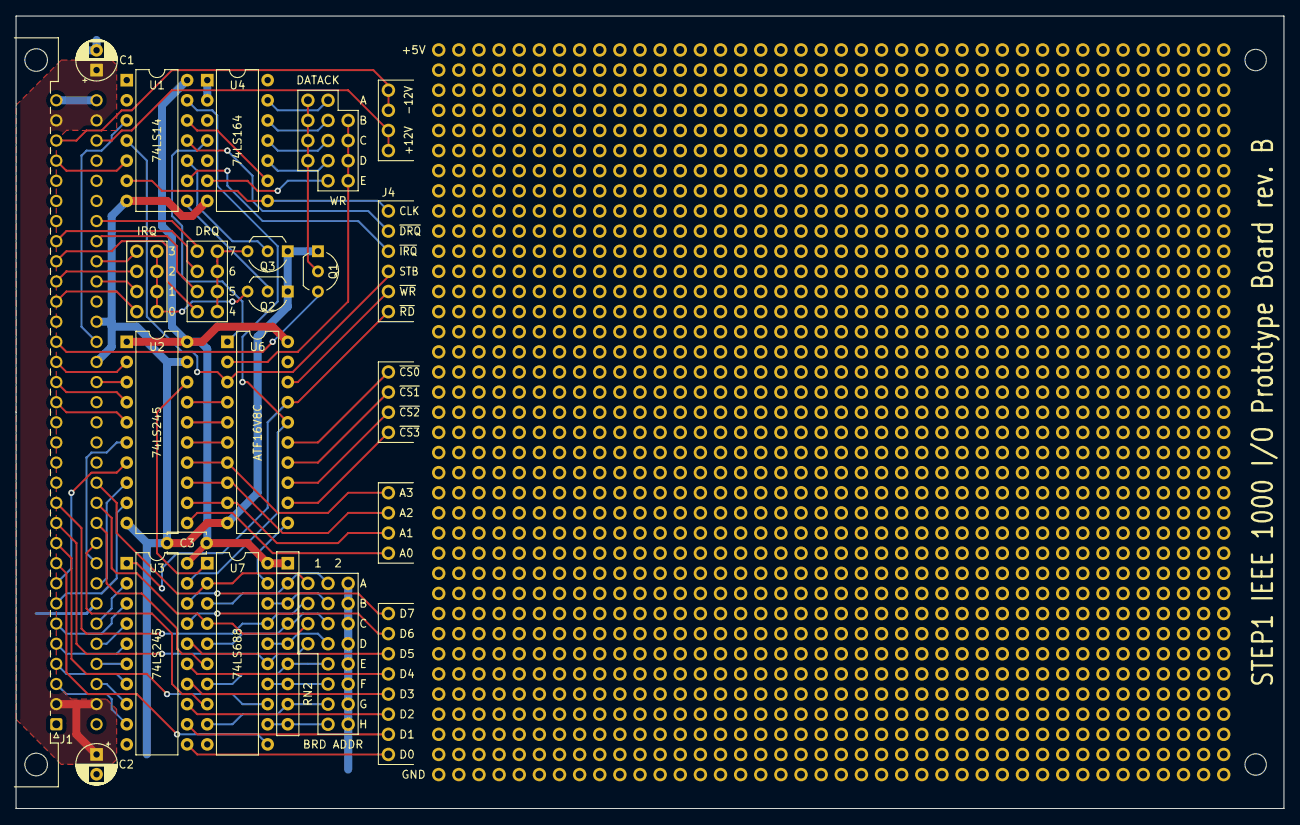
[picture p9: board STEP1.kicad_pcb from above]

Board: 2 copper layers, 160.0 x 100.0 mm, 43 parts (0 on the bottom side), 88 nets.
