dev-zzo/stebus/(commit log)

2021-01-19 adding S68k8 and STEP1
    [S68k8.kicad_pcb, S68k8.sch, STEP1.kicad_pcb, STEP1.sch, arbiter.sch, cpu.sch, memory.sch, stebus.sch]
2021-01-23 S68k8: change pull-up for DTACK to a separate resistor
    Tests show 4k7 is too large to pull the line back fast enough. Reducing to 1k or even 470R give much better results.
    [S68k8.kicad_pcb, cpu.sch, stebus.sch]
2021-01-23 S68k8: moved copper pours for power distribution to the bottom layer
    [S68k8.kicad_pcb, stebus.sch, sysctl.sch, uart.sch]
